msualt/hackclub_week3/README.md

# hackclub_week3
Stylophone redesigned for Hackclub Week 3

This is the render for my Stylophone. I've always thought they were cool, but also if you wanted to play it with your friends you were stuck to one instrument. I also noticed that they were just really bulky and large, as well as inconvenient to really carry. I designed this to be as thin and small as possible, and maybe to be able to carry it on a keychain if you really waned.

2d PCB

Schematic

BOM
| Item | Qty | Supplier | Cost/item | Total Cost | link |
| :--- | :-- | :--- | :--- | :--- | :--- |
| Double Rotary Gear Potentiometer | 1 | SHENZHEN YUXIN ELECTRONIC TECHNOLOGY CO.,  LTD | $1.90 | $1.90 | https://www.aliexpress.us/item/3256808822041313.html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 |
| Hc-49s | 1 | Shenzhen Baishun Microelectronics Co., Ltd. | $1.38 | $1.38 | https://www.aliexpress.us/item/3256806035288739.html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 |
| Mini Speaker | 1 | Eiechip | $3.85 | $3.85 | https://www.aliexpress.us/item/3256809614662750.html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 |
| 0603 Capacitors | 1 | PUMUDSY | $3.39 | $3.39 | https://www.aliexpress.us/item/3256809274295297.html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 |
| UCM0J221MCL1GS | 4 | Nichicon | $0.56 | $2.24 | https://www.digikey.com/en/products/detail/nichicon/UCM0J221MCL1GS/4991824 |
| MCP23017-E/SO | 4 | Microchip Technology | $1.62 | $6.48 | https://www.digikey.com/en/products/detail/microchip-technology/MCP23017-E-SO/894271https://www.digikey.com/en/products/detail/microchip-technology/MCP23017-E-SO/894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 |
| ATMEGA32U4-AU | 4 | Microchip Technology | $5.29 | $21.16 | https://www.digikey.com/en/products/detail/microchip-technology/ATMEGA32U4-AU/1914602 |
| LM386N-1 | 1 | Shenzhen crador Technology Co., Ltd. | $0.99 | $0.99 | https://www.aliexpress.us/item/3256806565410890.html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 |
| PCB | 1 | JLCPCB | $3.30 | $3.30 | https://jlcpcb.com |
| Multimeter Probe | 1 | XINGWEIQIANG-09 | $0.99 | $0.99 | https://www.aliexpress.us/item/3256805754330375.html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 |
| Multimeter Probe | 1 | ThinkingLeader | $0.99 | $0.99 | https://www.aliexpress.us/item/2251832802518998.html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 |
| 1x6 Pogo Pins | 1 | RTLECS Precision | $3.83 | $3.83 | https://www.aliexpress.us/item/3256804960956555.html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 |
| Estimated total shipping | 1 | | | $8.26 | |
