msualt/hackclub_week3/PCB.csv

Qty | Value | Device | Package | Parts | Description | AVAILABILITY | CATEGORY | CATEGORY_L1 | CATEGORY_L2 | CHECK_PRICES | COPYRIGHT | CORE | CREATOR | DATASHEET | DESCRIPTION | IO | MANUFACTURER | MANUFACTURER_NAME | MANUFACTURER_PART_NUMBER | MAXIMUM_PACKAGE_HEIGHT | MF | MP | MPN | OPERATING_TEMPERATURE | PACKAGE | PACKAGE_SIZE | PACKAGE_TYPE | PARTREV | PART_STATUS | PITCH | PRICE | ROHS | SERIES | SNAPEDA_LINK | SPEED | STANDARD | SUBCATEGORY | TEMPERATURE_COEFFICIENT | THERMALLOSS | TOLERANCE | TP_SIGNAL_NAME | TYPE | VALUE | VENDOR | VERIFIER | VOLTAGE_RATING | VPN
8 | 100n | C_CHIP-0603(1608-METRIC) | CAPC1608X85 | C1, C2, C3, C4, C5, C7, C9, C14 | Capacitor - Generic |  | Capacitor |  |  |  |  |  |  |  |  |  |  |  |  |  |  |  |  |  |  | 0603 | Surface Mount |  |  |  |  |  |  |  |  |  | Ceramic Capacitors |  |  |  |  | MLCC
1 | 100u | C_CHIP-0603(1608-METRIC) | CAPC1608X85 | C15 | Capacitor - Generic |  | Capacitor |  |  |  |  |  |  |  |  |  |  |  |  |  |  |  |  |  |  | 0603 | Surface Mount |  |  |  |  |  |  |  |  |  | Ceramic Capacitors |  |  |  |  | MLCC
2 | 10k | R_CHIP-0603(1608-METRIC) | RESC1608X60 | R5, R6 | Resistor Fixed - Generic |  | Resistors |  |  |  |  |  |  |  | Chip Resistor 1.60 X 0.82 X 0.60 mm body 0603(1608-METRIC) Package |  |  |  |  |  |  |  |  |  |  | 0603 | Surface Mount
1 | 10n | C_CHIP-0603(1608-METRIC) | CAPC1608X85 | C12 | Capacitor - Generic |  | Capacitor |  |  |  |  |  |  |  |  |  |  |  |  |  |  |  |  |  |  | 0603 | Surface Mount |  |  |  |  |  |  |  |  |  | Ceramic Capacitors |  |  |  |  | MLCC
1 | 10ohm | R_CHIP-0603(1608-METRIC) | RESC1608X60 | R2 | Resistor Fixed - Generic |  | Resistors |  |  |  |  |  |  |  | Chip Resistor 1.60 X 0.82 X 0.60 mm body 0603(1608-METRIC) Package |  |  |  |  |  |  |  |  |  |  | 0603 | Surface Mount
3 | 10u | C_CHIP-0603(1608-METRIC) | CAPC1608X85 | C6, C13, C16 | Capacitor - Generic |  | Capacitor |  |  |  |  |  |  |  |  |  |  |  |  |  |  |  |  |  |  | 0603 | Surface Mount |  |  |  |  |  |  |  |  |  | Ceramic Capacitors |  |  |  |  | MLCC
1 | 1k | R_CHIP-0603(1608-METRIC) | RESC1608X60 | R1 | Resistor Fixed - Generic |  | Resistors |  |  |  |  |  |  |  | Chip Resistor 1.60 X 0.82 X 0.60 mm body 0603(1608-METRIC) Package |  |  |  |  |  |  |  |  |  |  | 0603 | Surface Mount
1 | 1u | C_CHIP-0603(1608-METRIC) | CAPC1608X85 | C8 | Capacitor - Generic |  | Capacitor |  |  |  |  |  |  |  |  |  |  |  |  |  |  |  |  |  |  | 0603 | Surface Mount |  |  |  |  |  |  |  |  |  | Ceramic Capacitors |  |  |  |  | MLCC
2 | 22p | C_CHIP-0603(1608-METRIC) | CAPC1608X85 | C10, C11 | Capacitor - Generic |  | Capacitor |  |  |  |  |  |  |  |  |  |  |  |  |  |  |  |  |  |  | 0603 | Surface Mount |  |  |  |  |  |  |  |  |  | Ceramic Capacitors |  |  |  |  | MLCC
1 | 23072307 | 23072307 | 2307 | U$2
2 | 4.7k | R_CHIP-0603(1608-METRIC) | RESC1608X60 | R7, R8 | Resistor Fixed - Generic |  | Resistors |  |  |  |  |  |  |  | Chip Resistor 1.60 X 0.82 X 0.60 mm body 0603(1608-METRIC) Package |  |  |  |  |  |  |  |  |  |  | 0603 | Surface Mount
1 | 47n | C_CHIP-0603(1608-METRIC) | CAPC1608X85 | C18 | Capacitor - Generic |  | Capacitor |  |  |  |  |  |  |  |  |  |  |  |  |  |  |  |  |  |  | 0603 | Surface Mount |  |  |  |  |  |  |  |  |  | Ceramic Capacitors |  |  |  |  | MLCC
2 | 5.1k | R_CHIP-0603(1608-METRIC) | RESC1608X60 | R3, R4 | Resistor Fixed - Generic |  | Resistors |  |  |  |  |  |  |  | Chip Resistor 1.60 X 0.82 X 0.60 mm body 0603(1608-METRIC) Package |  |  |  |  |  |  |  |  |  |  | 0603 | Surface Mount
1 | ATMEGA32U4-AU | ATMEGA32U4-AU | QFP80P1200X1200X120-44 | U1 | 8-bit Microcontroller |  | Embedded ICs |  |  |  |  | AVR |  | https://ww1.microchip.com/downloads/en/DeviceDoc/Atmel-7766-8-bit-AVR-ATmega16U4-32U4_Datasheet.pdf | AVR AVR® ATmega Microcontroller IC 8-Bit 16MHz 32KB (16K x 16) FLASH 44-TQFP (10x10) | 26 | Microchip Technology |  |  |  |  |  | ATmega32U4-AU | -40°C ~ 85°C |  | 44-TQFP | Surface Mount |  | Active |  |  | Compliant | AVR® ATmega |  | 16MHz |  | Microcontrollers |  |  |  |  | 8-Bit
7 | B3U-X000B3U-1000P(M)1000P(M) | B3U-X000B3U-1000P(M)1000P(M) | B3U-1000P(M) | S1, S2, S3, S4, S5, S6, S7 | Ultra-small Tactile Switch Contact form : SPST-NO |  | Switches |  |  |  |  |  |  | https://omronfs.omron.com/en_US/ecb/products/pdf/en-b3u.pdf | Tactile Switch SPST-NO Top Actuated Surface Mount |  | Omron Electronics Inc-EMC Div |  |  |  |  |  | B3U-1000PM | -25°C ~ 70°C |  | NA | SMD |  | ACTIVE |  |  | COMPLIANT | B3U |  |  |  | Tactile Switches |  |  |  |  | SPST-NO
1 | HC-49/U-S16000000ABJB | HC-49/U-S16000000ABJB | XTAL_HC49P488W43L1150T466H350 | Y1 | Check availability | In Stock |  |  |  | https://www.snapeda.com/parts/HC-49/U-S16000000ABJB/Citizen/view-part/?ref=eda |  |  |  |  | 16 MHz ±30ppm Crystal 18pF 50 Ohms HC-49/US |  |  |  |  |  | Citizen Finedevice | HC-49/U-S16000000ABJB |  |  | HC-49/US Citizen Finetech Miyota |  |  |  |  |  | None |  |  | https://www.snapeda.com/parts/HC-49/U-S16000000ABJB/Citizen/view-part/?ref=snap
1 | LM386N-1/NOPBN08E_TEX | LM386N-1/NOPBN08E_TEX | N08E_TEX | U3 |  |  |  |  |  |  | Copyright (C) 2026 Ultra Librarian. All rights reserved. |  |  | https://www.ti.com/lit/gpn/lm386 | 700-mW | mono | 5- to 18-V | analog input Class-AB audio amplifier 8-PDIP 0 to 70 |  |  | Texas Instruments | LM386N-1/NOPB
1 | MCP23017-E/SO | MCP23017-E/SO | SOIC127P1030X265-28N | U2 | Check availability | In Stock |  |  |  | https://www.snapeda.com/parts/MCP23017-E/SO/Microchip+Technology/view-part/?ref=eda |  |  |  |  | I/O Port Expander | 16-Bit | I2C I'face | SOIC-28 | Microchip Technology Inc. MCP23017-E/SO |  |  |  |  |  | Microchip | MCP23017-E/SO |  |  | SOIC-28 Microchip |  |  |  |  |  | None |  |  | https://www.snapeda.com/parts/MCP23017-E/SO/Microchip+Technology/view-part/?ref=snap
1 | PAD | PAD | 2.54/1.0 | J3 | Through-Hole Pad |  | Connectors |  |  |  |  |  |  |  | Pad with 2.54 mm diamater and 1mm drill |  |  |  |  |  |  |  |  |  |  | NA | Through Hole |  |  | NA
1 | POT3POT3 | POT3POT3 | POT3 | U$3
1 | STYLOPHONEPAD | STYLOPHONEPAD | STYLOPHONEPCB | U$1
6 | TPTP127R | TPTP127R | TP127R | TP.5V, TP.GND, TP.MISO, TP.MOSI, TP.RESET, TP.SCK | Test Pad |  |  | Test Points |  |  |  |  |  |  | Test Point Round 1.27mmx1.27mm
1 | UCM0J221MCL1GSCAP_UCD_5X5P8_NCH | UCM0J221MCL1GSCAP_UCD_5X5P8_NCH | CAP_UCD_5X5P8_NCH | C17 |  |  |  |  |  |  | Copyright (C) 2026 Ultra Librarian. All rights reserved. |  |  |  |  |  |  | Nichicon | UCM0J221MCL1GS
1 | USB4215-03-A_REVAUSB4115-03-C_REVA | USB4215-03-A_REVAUSB4115-03-C_REVA | GCT_USB4215-03-A_REVA | J1 |  |  |  |  |  |  |  |  | Amina |  |  |  | Global Connector Technology |  |  | 3.16mm |  |  |  |  |  |  |  | A |  |  |  |  |  |  |  | Manufacturer Recommendations |  |  |  |  |  |  |  |  | Your name | use the same always
