msualt/hackclub_week3/PCB.brd

## EAGLE design PCB.brd (2026-11-13)

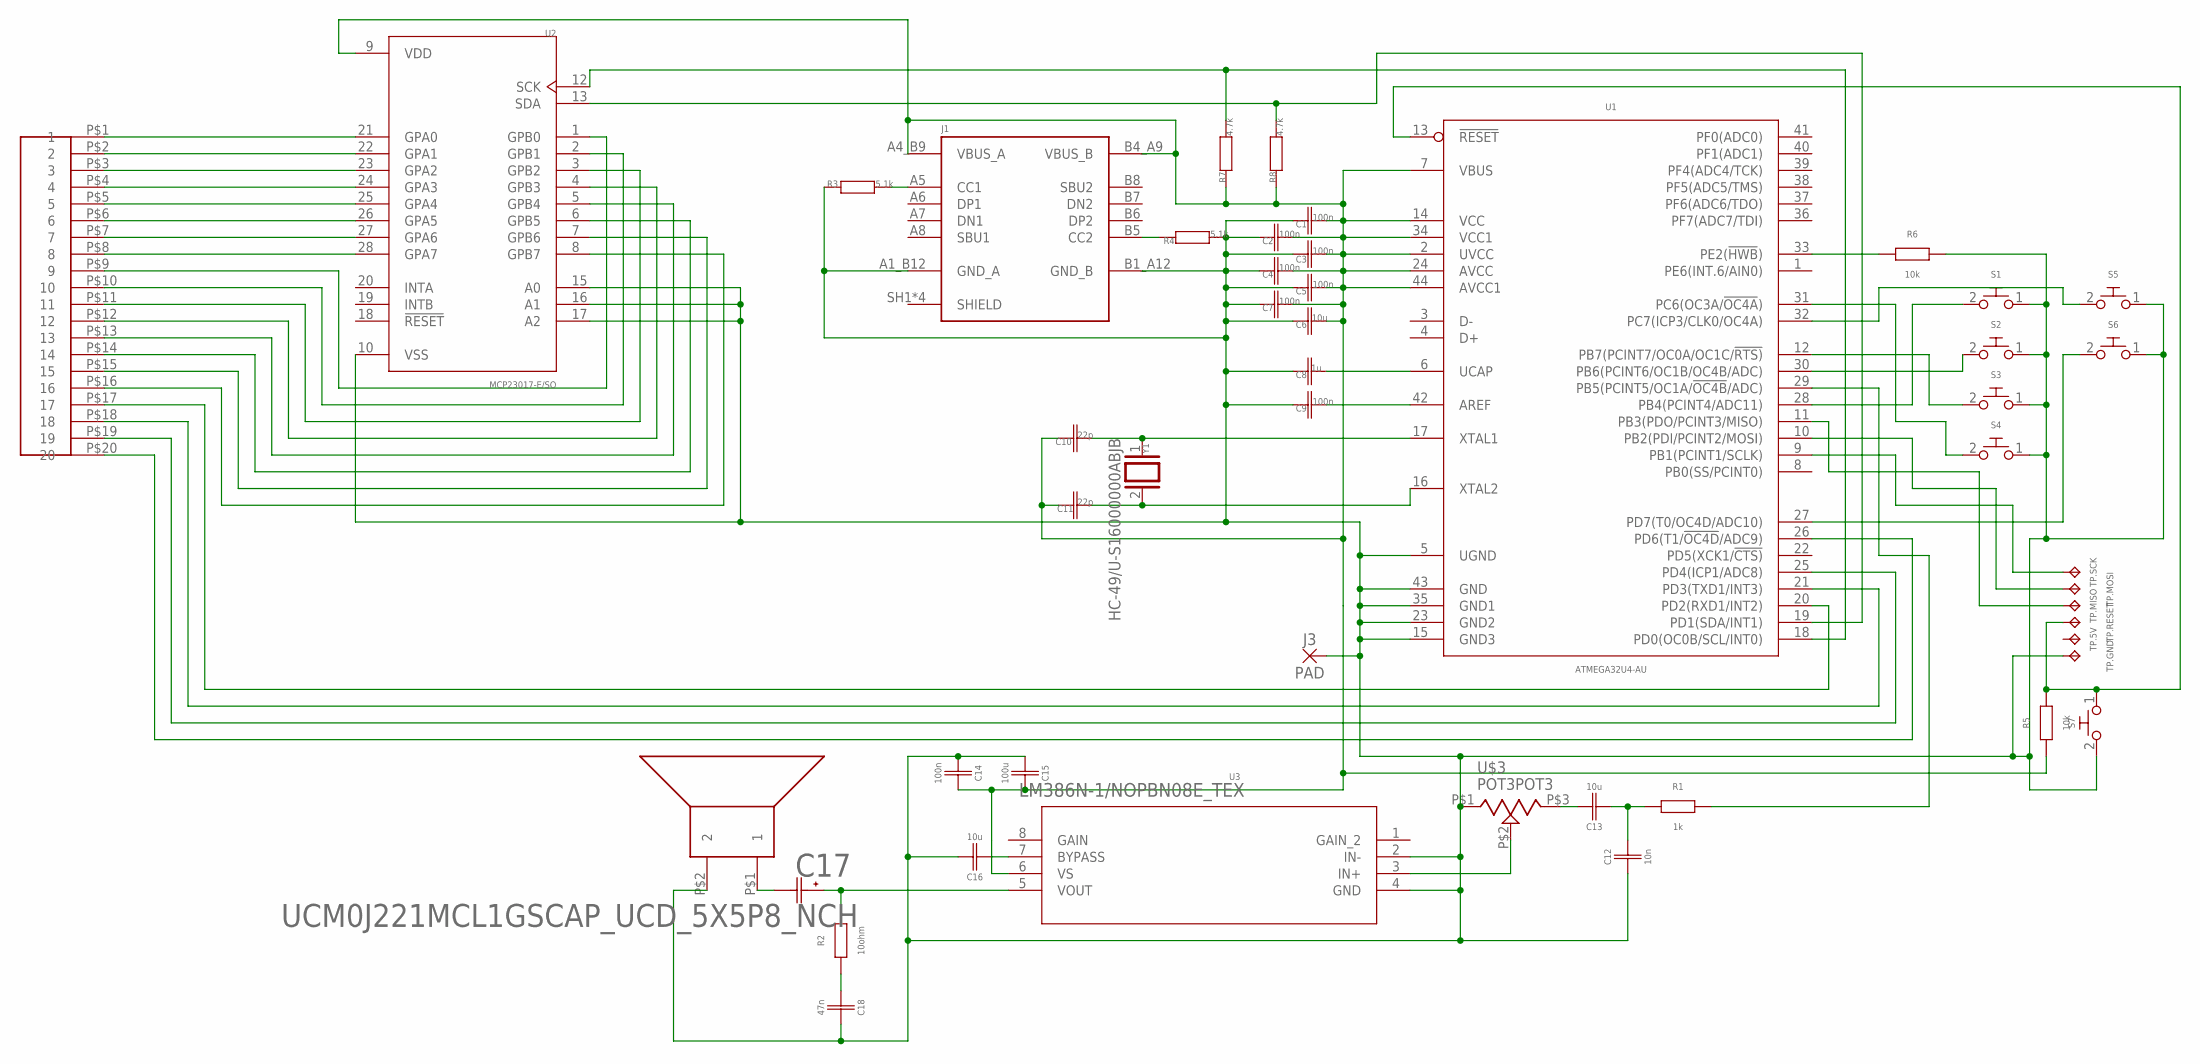
[picture p1: schematic Schematic.sch]

Parts:
C1, C2, C3, C4, C5, C7, C9, C14: 100n; CAPC1608X85
C6, C13, C16: 10u; CAPC1608X85
C8: 1u; CAPC1608X85
C10, C11: 22p; CAPC1608X85
C12: 10n; CAPC1608X85
C15: 100u; CAPC1608X85
C17: UCM0J221MCL1GSCAP_UCD_5X5P8_NCH; CAP_UCD_5X5P8_NCH
C18: 47n; CAPC1608X85
J1: USB4215-03-A_REVAUSB4115-03-C_REVA; GCT_USB4215-03-A_REVA
J3: PAD; 2.54/1.0
R1: 1k; RESC1608X60
R2: 10ohm; RESC1608X60
R3, R4: 5.1k; RESC1608X60
R5, R6: 10k; RESC1608X60
R7, R8: 4.7k; RESC1608X60
S1, S2, S3, S4, S5, S6, S7: B3U-X000B3U-1000P(M)1000P(M); B3U-1000P(M)
TP.5V, TP.GND, TP.MISO, TP.MOSI, TP.RESET, TP.SCK: TPTP127R; TP127R
U1: ATMEGA32U4-AU; QFP80P1200X1200X120-44
U2: MCP23017-E/SO; SOIC127P1030X265-28N
U3: LM386N-1/NOPBN08E_TEX; N08E_TEX
U$1: STYLOPHONEPAD; STYLOPHONEPCB
U$2: 23072307; 2307
U$3: POT3POT3; POT3
Y1: HC-49/U-S16000000ABJB; XTAL_HC49P488W43L1150T466H350

Connections:
5V: C1.1, C2.1, C3.1, C4.1, C5.1, C6.1, C7.1, C10.2, C11.2, C14.2, C15.2, J1.A4_B9 (VBUS_A), J1.B4_A9 (VBUS_B), R5.1, R7.1, R8.1, U1.2 (UVCC), U1.7 (VBUS), U1.14 (VCC), U1.24 (AVCC), U1.34 (VCC1), U1.44 (AVCC1), U2.9 (VDD), U3.6 (VS)
GND: C1.2, C2.2, C3.2, C4.2, C5.2, C6.2, C7.2, C8.2, C9.2, C12.1, C14.1, C15.1, C16.2, C18.2, J1.A1_B12 (GND_A), J1.B1_A12 (GND_B), J3.1, R3.2, R4.1, R6.2, S1.1, S2.1, S3.1, S4.1, S5.1, S6.1, S7.2, TP.GND.TP, U1.5 (UGND), U1.15 (GND3), U1.23 (GND2), U1.35 (GND1), U1.43 (GND), U2.10 (VSS), U2.15 (A0), U2.16 (A1), U2.17 (A2), U3.2 (IN-), U3.4 (GND), U$2.P$2 (2), U$3.P$1 (CCW)
unnamed: R7.2, U1.18 (PD0(OC0B/SCL/INT0)), U2.12 (SCK)
unnamed: R8.2, U1.19 (PD1(SDA/INT1)), U2.13 (SDA)
unnamed: U2.21 (GPA0), U$1.P$1 (1)
unnamed: U2.22 (GPA1), U$1.P$2 (2)
unnamed: U2.23 (GPA2), U$1.P$3 (3)
unnamed: U2.24 (GPA3), U$1.P$4 (4)
unnamed: U2.25 (GPA4), U$1.P$5 (5)
unnamed: U2.26 (GPA5), U$1.P$6 (6)
unnamed: U2.27 (GPA6), U$1.P$7 (7)
unnamed: U2.28 (GPA7), U$1.P$8 (8)
unnamed: U2.1 (GPB0), U$1.P$9 (9)
unnamed: U2.2 (GPB1), U$1.P$10 (10)
unnamed: U2.3 (GPB2), U$1.P$11 (11)
unnamed: U2.4 (GPB3), U$1.P$12 (12)
unnamed: U2.5 (GPB4), U$1.P$13 (13)
unnamed: U2.6 (GPB5), U$1.P$14 (14)
unnamed: U2.7 (GPB6), U$1.P$15 (15)
unnamed: U2.8 (GPB7), U$1.P$16 (16)
unnamed: U1.20 (PD2(RXD1/INT2)), U$1.P$17 (17)
unnamed: U1.21 (PD3(TXD1/INT3)), U$1.P$18 (18)
unnamed: U1.25 (PD4(ICP1/ADC8)), U$1.P$19 (19)
unnamed: U1.26 (PD6(T1/!OC4D!/ADC9)), U$1.P$20 (20)
unnamed: S1.2, U1.28 (PB4(PCINT4/ADC11))
unnamed: S2.2, U1.30 (PB6(PCINT6/OC1B/OC4B/ADC))
unnamed: S3.2, U1.12 (PB7(PCINT7/OC0A/OC1C/!RTS))
unnamed: S4.2, U1.31 (PC6(OC3A/!OC4A!))
unnamed: S5.2, U1.32 (PC7(ICP3/CLK0/OC4A))
unnamed: S6.2, U1.27 (PD7(T0/OC4D/ADC10))
unnamed: C18.1, R2.1
unnamed: R1.2, U1.29 (PB5(PCINT5/OC1A/!OC4B!/ADC))
unnamed: C12.2, C13.1, R1.1
unnamed: C13.2, U$3.P$3 (CW)
unnamed: U3.3 (IN+), U$3.P$2 (WIPER)
unnamed: C16.1, U3.7 (BYPASS)
unnamed: C9.1, U1.42 (AREF)
unnamed: C11.1, U1.16 (XTAL2), Y1.2
unnamed: C17.1, R2.2, U3.5 (VOUT)
unnamed: J1.B5 (CC2), R4.2
unnamed: J1.A5 (CC1), R3.1
unnamed: C8.1, U1.6 (UCAP)
unnamed: R6.1, U1.33 (PE2(!HWB!))
unnamed: TP.SCK.TP, U1.9 (PB1(PCINT1/SCLK))
unnamed: TP.MOSI.TP, U1.10 (PB2(PDI/PCINT2/MOSI))
unnamed: TP.MISO.TP, U1.11 (PB3(PDO/PCINT3/MISO))
unnamed: R5.2, S7.1, TP.RESET.TP, U1.13 (!RESET)
unnamed: C10.1, U1.17 (XTAL1), Y1.1
unnamed: C17.2, U$2.P$1 (1)

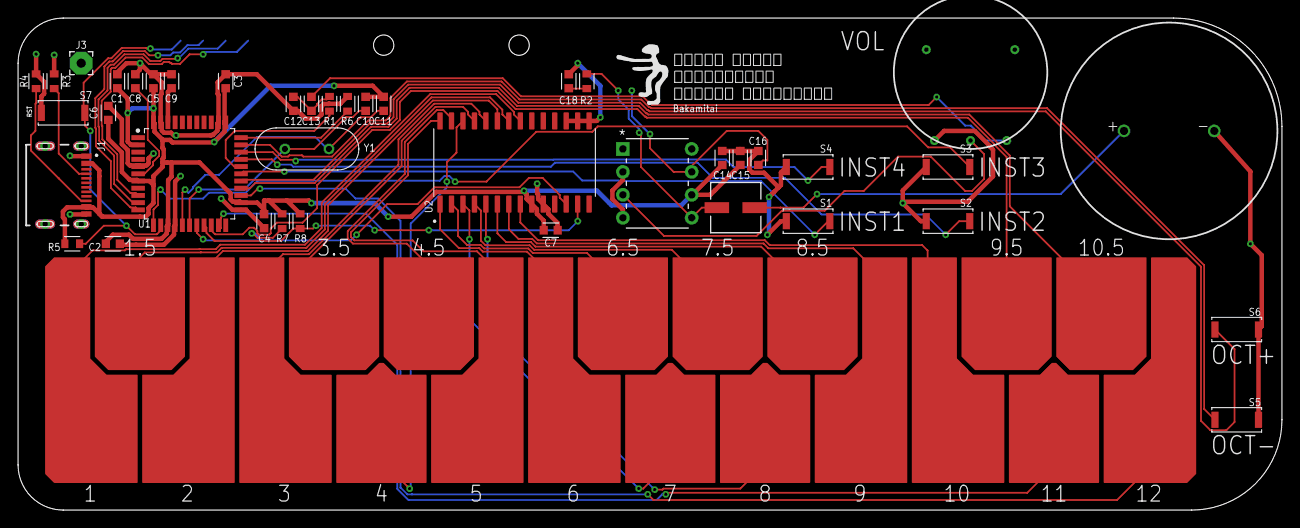
[picture p2: board PCB.brd from above]

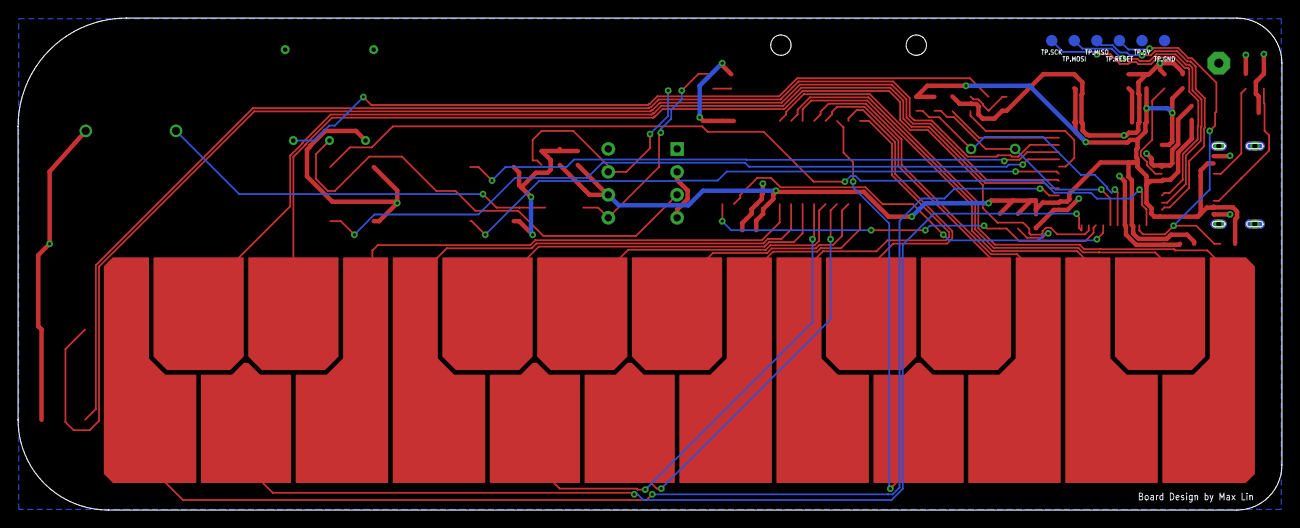
[picture p3: board PCB.brd from below]

Board: 2 copper layers, 140.0 x 54.5 mm, 48 parts (6 on the bottom side), 49 nets.
