msualt/hackclub_week3/JOURNAL.md

# Stylophone Plus: devlog

<!-- Generated by Half Life from project cmvfestic004q01q7diw5fw1y. Edits here are overwritten on the next sync. -->
<!-- Generated: 2026-10-24T03:17:16.442Z -->

> [!NOTE]
> This devlog is mirrored from [Half Life](https://halflife.hackclub.com) ([open the project](https://halflife.hackclub.com/projects/cmvfestic004q01q7diw5fw1y)). Editing it here will not change the platform's copy, and the next sync overwrites this file.

> Stylophone that is lighter and more compact, with more instruments to choose from and an octave selector

| Week | Tier | Hours logged | Entries |
| --- | --- | --- | --- |
| Week 3 | Tier 2 | 17.71h | 2 |

## Contents

1. [2026-10-22: 10/22 (and other days)](#2026-10-22-1022-and-other-days)
2. [2026-10-23: 10/23](#2026-10-23-1023)

## Design

### 2026-10-22: 10/22 (and other days)

**7.58h**

10/22 (and other days)

I started before this planning the project and getting some of the components together

Today however, I started actually making the pcb


This is my drafted schematic (definitely will change)


This is the 2d PCB.  I had to custom make the speaker and the potentiometer since they are too generic (or too niche?) to find an actual good footprint, so it took a good chunk of my time
As you can see there are floating components, ill get to them tomorrow


Here's the 3d pcb. Some components are missing, I still need to add their models
As you can see the soldermask covers the  stylophone pads even though i specifically set a STOP layer. ill deal with that tomorrow too

[Timelapse](https://lookout.hackclub.com/api/media/f38161e7-b79d-4097-8adb-c17baf0b75cf/video.mp4)

[Timelapse](https://lookout.hackclub.com/api/media/eb3eca01-ba84-4144-a40d-ec36de36448e/video.mp4)

### 2026-10-23: 10/23

**10.13h**

10/23
Pretty much  finished the pcb



All nice and rendered too!
The stylus (multimeter probe) and the clip for it  aren't in the render because i am not going to bother modeling a wire. plus it doesn't add anything really


This  is the 2d pcb. a lot of the components (speaker, potentiometer, the stylophone pads, etc were actually my own footprint since i couldn't find any footprints of them)


Schematic. I hope this is comprehensible, because I don't know the proper way of making these.


Digikey cart (why is digikey so expensive?)


Aliexpress cart


JLCPCB cart. I chose black  because I thought it would look cool.


Almost forgot, using these test points I'm going to use pogo pins to upload the firmware

[Timelapse](https://lookout.hackclub.com/api/media/a73d6039-9394-41d4-8ad9-9856ba1c404b/video.mp4)
