msualt/hackclub_week3/(commit log)

2026-11-13 Sync Stylophone Plus from Half Life
    [BOM.csv]
2026-11-13 Add BOM section with item details and costs
    Added a Bill of Materials (BOM) section with item details, suppliers, and costs.
