msualt/hackclub_week3/(notices)

Notices in the files:
parts and their libraries:
2026-10-22_22-21-42_Library: COPYRIGHT: Copyright (C) 2026 Ultra Librarian. All rights reserved.
